phamtaiece/ECE411/Design goals/block diagram.jpg

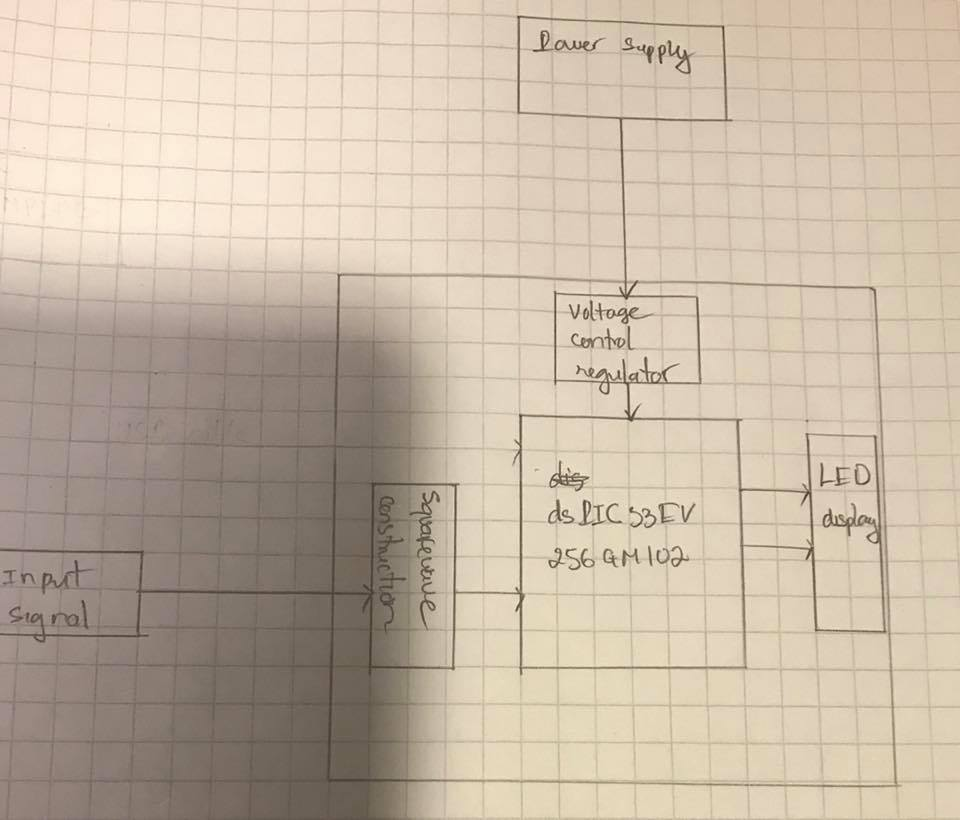
Design goals/block diagram.jpg
