phamtaiece/ECE411/Design schematic and relates/schematic.jpg

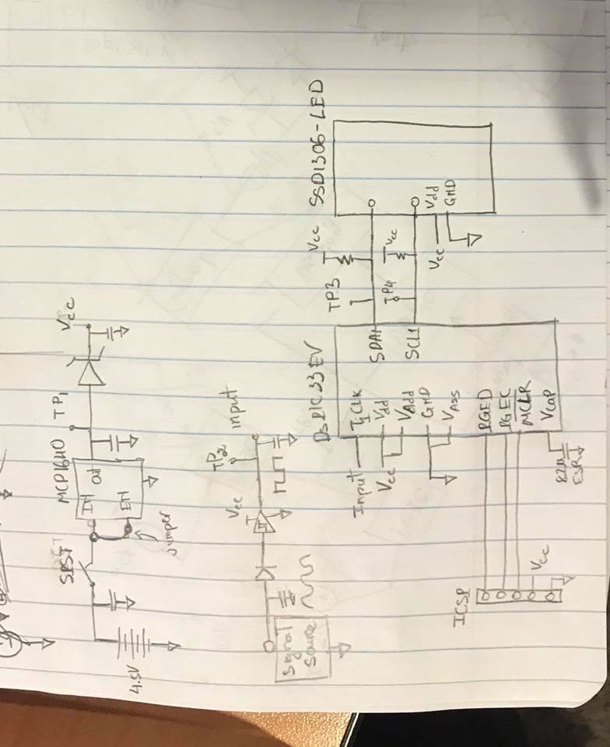
Design schematic and relates/schematic.jpg
