phamtaiece/ECE411/README.md

# ECE411
This is for ECE411 practicum. 
The project idea is where we post our idea. Come and contribute and have fun.
