phamtaiece/ECE411/Documents/Readme

I2c_fun help you how to turn on I2C communication. Using I2CCON1 or I2CCON2
Clicker_18F.... Help you about SSD1306 LED screen
FrequencyCounter source code... maybe helpful.
