phamtaiece/ECE411/Block Diagram.pdf

Level 0: Block Diagram

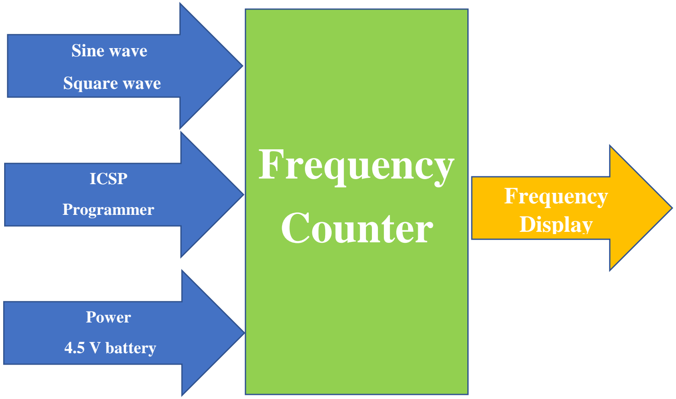
[picture p3: figure]
Sine wave; Square wave; ICSP; Programmer; Power; 4.5 V battery; Frequency; Counter; Frequency Display

Level 1: Block diagram

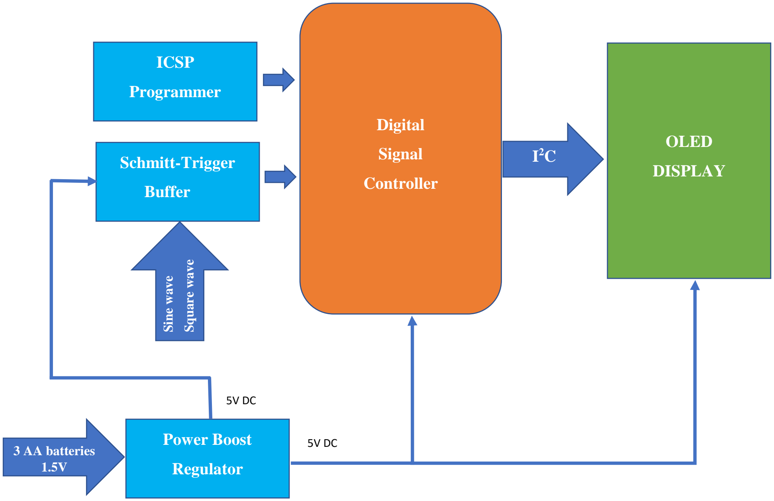
[picture p4: figure]
Power Boost; Regulator; 3 AA batteries 1.5V; Sine; wave; Square wave; Schmitt-Trigger; Buffer; ICSP; Programmer; Digital; Signal; Controller; OLED; DISPLAY
