phamtaiece/ECE411/BOM - Schematics - Layout/schematic.PNG

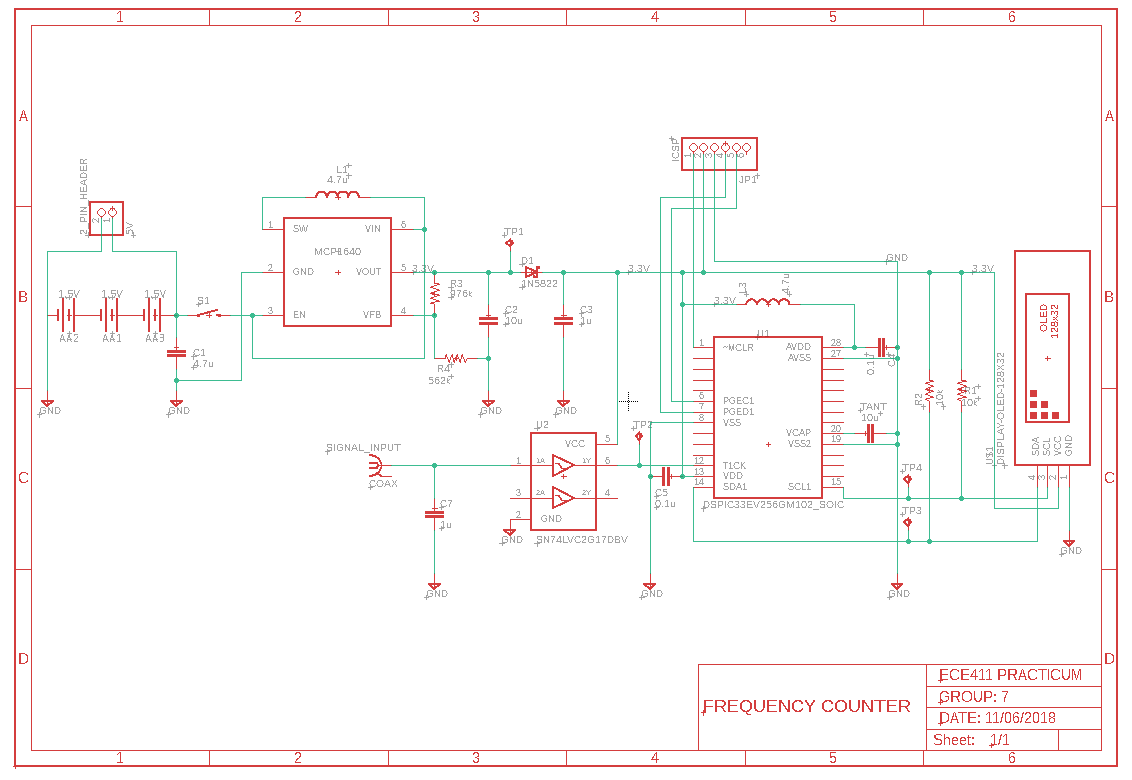
BOM - Schematics - Layout/schematic.PNG
