phamtaiece/ECE411/dsPIC33EV datasheet and relates/dsPIC Oscillator layout.jpg

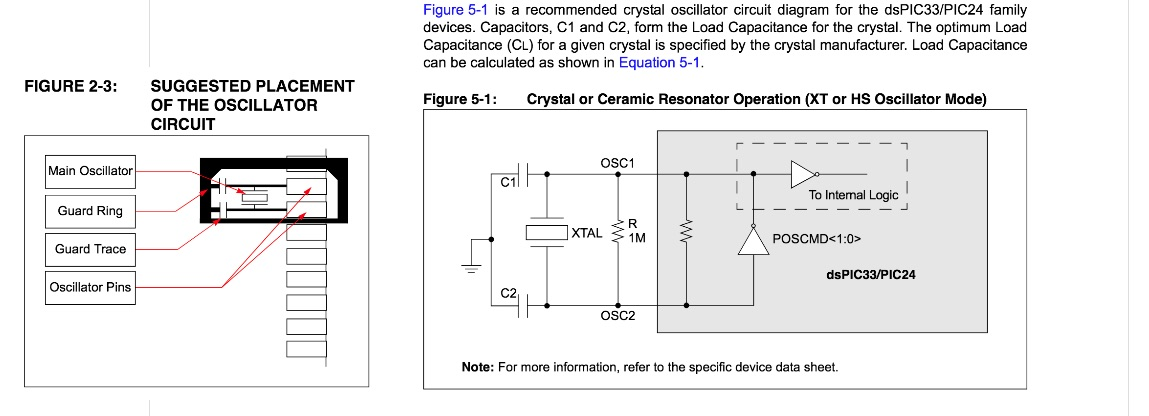
dsPIC33EV datasheet and relates/dsPIC Oscillator layout.jpg
