phamtaiece/ECE411/BOM - Schematics - Layout/Readme

BOM - Schematics - Layout for Frequency Counter
