phamtaiece/ECE411/BOM - Schematics - Layout/Practicum_BOM_11-9-18.ods

Device | Value | Package | Parts | Description | MFG | MPN | Vendor | Price | Qty | Subtotal
Resistor | 10k 1% | 0805 | R1 R2 | Resistor – Thick Film | Bourns | 652-CR0805FX-1002ELF | Mouser | $0.10 | 2 | $0.20
Resistor | 562K 1% | 0805 | R4 | Resistor – Thick Film | Bourns | 652-CR0805FX-5623ELF | Mouser | $0.10 | 1 | $0.10
Resistor | 976k 1% | 0805 | R3 | Resistor – Thick Film | Bourns | 652-CR0805FX-9763ELF | Mouser | $0.10 | 1 | $0.10
Capacitor | 0.1u 20% | 0805 | C4 C5 | Capacitor – Ceramic | KEMET | C0805C104M5RACTU | Mouser | $0.10 | 2 | $0.20
Capacitor | 10u 20% | Radial leaded | C2 | Capacitor – Aluminum Electrolytic | Panasonic | ECA-1HM100I | Mouser | $0.16 | 1 | $0.16
Capacitor | 10u 20% | Radial leaded | TANT | Capacitor – Aluminum Polymer | KEMET | A758BG106M1EAAE070 | Mouser | $0.47 | 1 | $0.47
Capacitor | 1u 20% | 0805 | C3 C7 | Capacitor – Ceramic | KEMET | C0805C104M5RACTU | Mouser | $0.13 | 2 | $0.26
Capacitor | 4.7u 20% | Radial leaded | C1 | Capacitor – Aluminum Electrolytic | KEMET | ESK475M100AC3AA (https://www.mouser.com/ProductDetail/KEMET/ESK475M100AC3AA) | Mouser | $0.10 | 1 | $0.10
Inductor | 4.7u 20% | 0805 | L1 L2 | Inductor – multi-layer | Bourns | 652-CV201210-4R7K | Mouser | 0.1 | 2 | $0.20
Battery Holder | 3x AA |  |  | 3x AA | Keystone | 2464 | Mouser | $1.43 | 1 | $1.43
BNC connector | Male | PC-mount |  | BNC Male Right-angle | Molex | 73137-5003 | Mouser | $1.97 | 1 | $1.97
Schmitt Buffer |  | SOT-26 |  | Dual Schmitt-trigger Buffer | Texas Instruments | SN74LVC2G17DBV | Mouser | $0.53 | 1 | $0.53
Switch | SPST | Solder Lug |  | Slide switch Right-angle | TE Connectivity | 1825232-1 | Mouser | $0.31 | 1 | $0.31
6-pin Header | 1 row 6 position | SIP-6 |  | Inline 6-position pin header | Harwin | M50-3530642 | Mouser | $0.24 | 1 | $0.24
PMIC |  | SOT-26 |  | MCP1640 | Microchip | MCP1640T-I/CHY | Mouser | $0.59 | 1 | $0.59
DSP |  | SOIC-28 |  | dsPIC33EV | Microchip | dsPIC33EV265GM102TI/SO | Mouser | $3.69 | 1 | $3.69
OLED backpack |  | SIP-4 |  | 128X32 OLED display with SSD1306 controller | MakerFocus | B079BN2J8V | Amazon | $5.50 | 1 | $5.50
 |  |  |  |  |  |  |  |  |  | $16.05
