phamtaiece/ECE411/411_SCH_FINAL.brd

## EAGLE design 411_SCH_FINAL.brd (2018-12-01)

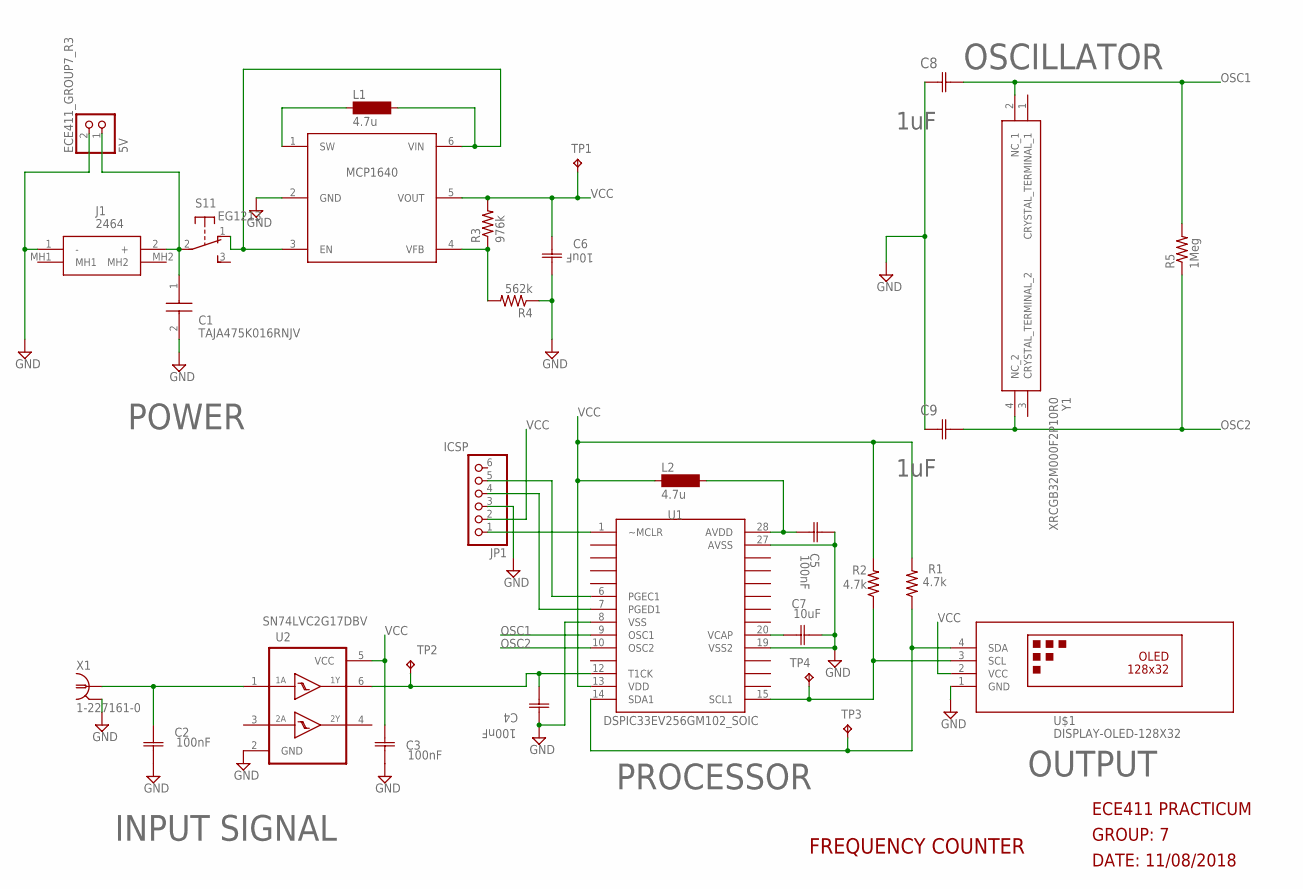
[picture p7: schematic 411_SCH_FINAL.sch]

Parts:
C1: TAJA475K016RNJV; CAPPM3216X180N
C2, C3, C4, C5: 100nF; CAPC2013X110N
C6, C7: 10uF; CAPC2013X140N
C8, C9: 1uF; CAPC2013X110N
ECE411_GROUP7_R3: 5V; JST-PH-2-THM-RA; MPN M20-9990246
J1: 2464
JP1: ICSP; 1X06
L1, L2: 4.7u; SM-1206
MCP1: MCP1640; SOP95P270X145-6; MPN MCP1640DT-I/CHY
R1, R2: 4.7k; M2012; MPN CR1206-JW-114ELF
R3: 976k; R0805
R4: 562k; R0805
R5: 1Meg; M0805
S1: EG1213
TP1, TP2, TP3, TP4: TPB1,27; B1,27
U1: DSPIC33EV256GM102_SOIC; SOIC127P1020X265-28; MPN DSPIC33EV256GM102
U2: SN74LVC2G17DBV; SOT23-6; MPN NC7WZ14P6X
U$1: DISPLAY-OLED-128X32; MPN SSD1306
X1: 1-227161-0; AMP_227161
Y1: XRCGB32M000F2P10R0; XRCGB32_F

Connections:
BATT: L1.2, MCP1.3 (EN), MCP1.6 (VIN), S1.1 (O)
GND: C1.2 (-), C2.2 (C2), C3.2 (C2), C4.2 (C2), C5.1 (C1), C6.2 (C2), C7.2 (C2), C8.1 (C1), C9.1 (C1), ECE411_GROUP7_R3.2 (1), J1.1 (-), JP1.3, MCP1.2 (GND), R4.1, U1.8 (VSS), U1.19 (VSS2), U1.27 (AVSS), U2.2 (GND), U$1.1 (GND), X1.2
unnamed: C7.1 (C1), U1.20 (VCAP)
unnamed: C1.1 (+), ECE411_GROUP7_R3.1 (2), J1.2 (+), S1.2
unnamed: R1.1, TP3.TP, U1.14 (SDA1), U$1.4 (SDA)
unnamed: C2.1 (C1), U2.1 (1A), X1.1
unnamed: C5.2 (C2), L2.2, U1.28 (AVDD)
unnamed: L1.1, MCP1.1 (SW)
unnamed: MCP1.4 (VFB), R3.1, R4.2
unnamed: JP1.1, U1.1 (~MCLR)
unnamed: R2.1, TP4.TP, U1.15 (SCL1), U$1.3 (SCL)
unnamed: JP1.4, U1.7 (PGED1)
unnamed: JP1.5, U1.6 (PGEC1)
unnamed: C4.1 (C1), TP2.TP, U1.12 (T1CK), U2.6 (1Y)
OSC1: C8.2 (C2), R5.2, U1.9 (OSC1), Y1.2 (NC_1)
OSC2: C9.2 (C2), R5.1, U1.10 (OSC2), Y1.4 (NC_2)
VCC: C3.1 (C1), C6.1 (C1), JP1.2, L2.1, MCP1.5 (VOUT), R1.2, R2.2, R3.2, TP1.TP, U1.13 (VDD), U2.5 (VCC), U$1.2 (VCC)

Notes on the sheet:
GROUP: 7
DATE: 11/08/2018
FREQUENCY COUNTER
ECE411 PRACTICUM
POWER
INPUT SIGNAL
OUTPUT
PROCESSOR
OSCILLATOR

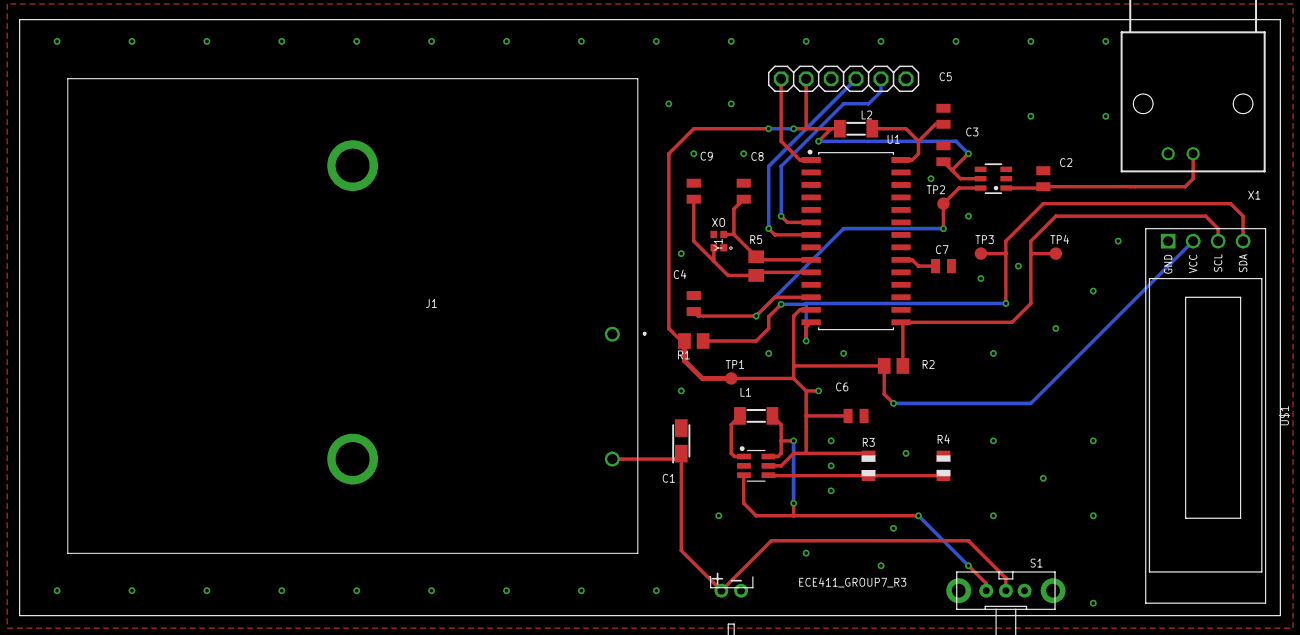
[picture p8: board 411_SCH_FINAL.brd from above]

Board: 2 copper layers, 128.2 x 60.6 mm, 30 parts (0 on the bottom side), 17 nets.
