phamtaiece/ECE411/freq_count_schematic_updated_11_6_2018.brd

## EAGLE design freq_count_schematic_updated_11_6_2018.brd (2018-11-08)

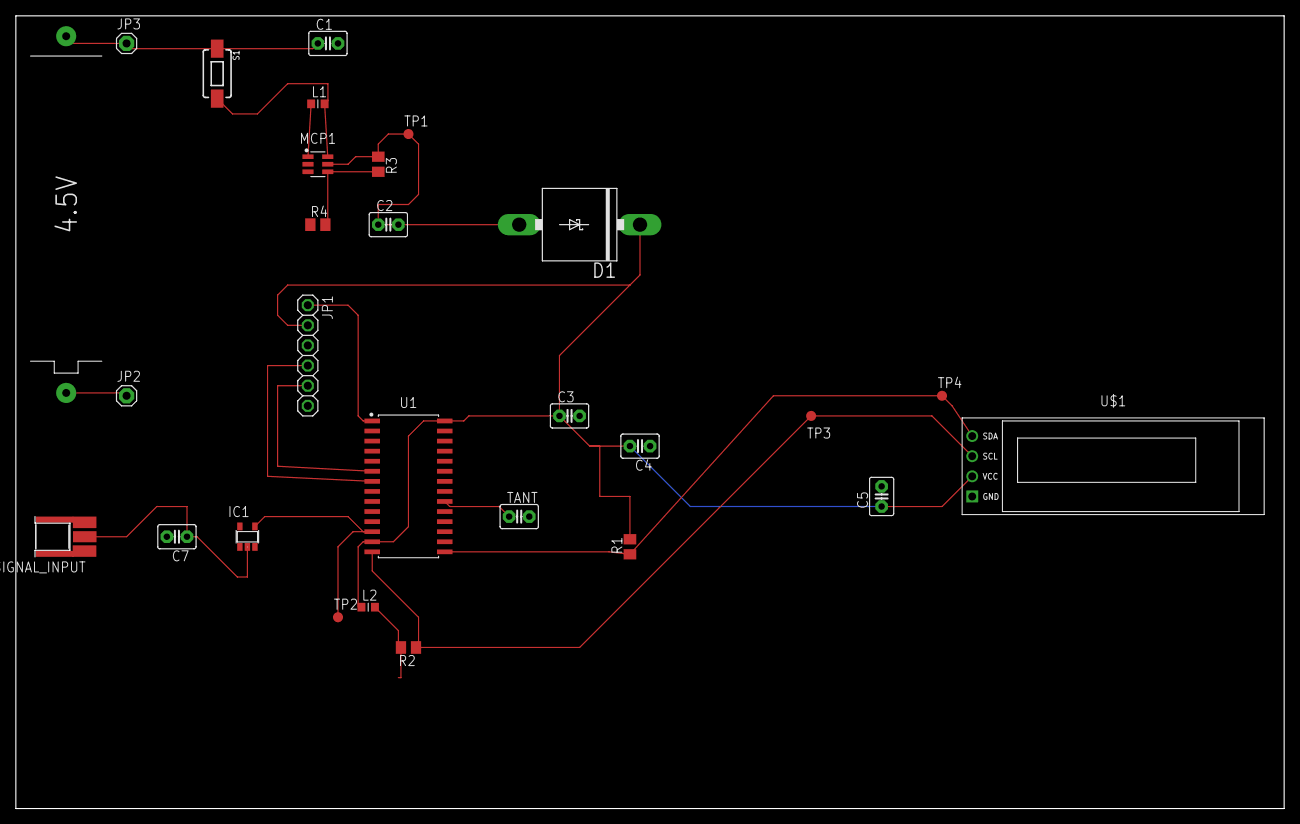
[picture p9: board freq_count_schematic_updated_11_6_2018.brd from above]

Board: 2 copper layers, 160.0 x 100.0 mm, 28 parts (0 on the bottom side), 15 nets.

Parts:
4.5V: AAA; 12BH412
C1: 4.7u; C2.5-3
C2: 10u; C2.5-3
C3, C7: 1u; C2.5-3
C4, C5: 0.1u; C2.5-3
D1: AG
IC1: 74AHC1G14DBV; SOT23-5
JP1: 1X06
JP2, JP3: 1X01
L1: 4.7u; L0603
L2: L0603
MCP1: MCP1640; SOP95P270X145-6
R1, R2: 10k; M2012
R3: 976k; M2012
R4: 562k; M2012
S1: RS032G05A3SM-SPST-MOMENTARY-SWSMD-1101NE; TACTILE-SWITCH-1101NE
SIGNAL_INPUT: COAX; MMCX-J-P-X-ST-EM1-MKT
TANT: 10u; C2.5-3
TP1, TP2, TP3, TP4: TPB1,27; B1,27
U1: DSPIC33EV256GM102_SOIC; SOIC127P1020X265-28
U$1: DISPLAY-OLED-128X32

Connections:
GND: 4.5V.+, C1.2, C2.2, C3.2, C4.1, C5.2, C7.2, IC1.3, JP1.3, JP2.1, MCP1.2, R4.1, SIGNAL_INPUT.2@1, SIGNAL_INPUT.2@2, SIGNAL_INPUT.2@3, SIGNAL_INPUT.2@4, TANT.2, U1.8, U1.19, U1.27, U$1.1
unnamed: TANT.1, U1.20
unnamed: 4.5V.-, C1.1, JP3.1, S1.1
unnamed: L1.2, MCP1.3, MCP1.6, S1.2
unnamed: C3.1, C4.2, C5.1, D1.C, JP1.2, L2.1, L2.2, R1.2, R2.2, U1.13, U1.28, U$1.2
unnamed: R1.1, TP4.TP, U1.15, U$1.4
unnamed: C7.1, IC1.2, SIGNAL_INPUT.1
unnamed: IC1.4, TP2.TP, U1.12
unnamed: C2.1, D1.A, MCP1.5, R3.1, TP1.TP
unnamed: R2.1, TP3.TP, U1.14, U$1.3
unnamed: L1.1, MCP1.1
unnamed: MCP1.4, R3.2, R4.2
unnamed: JP1.1, U1.1
unnamed: JP1.4, U1.7
unnamed: JP1.5, U1.6
