phamtaiece/ECE411/I2C_SSD1306/oled.h

/* 
 * File:   oled.h
 * Author: samwirshup
 *
 * Created on December 4, 2018, 2:47 PM
 */

/*
As this library is practically a a port of some of the functions available in
the Adafruit OLED library, all work here falls under their licencing aggreement:

Software License Agreement (BSD License)

Copyright (c) 2012 Adafruit Industries.  All rights reserved.

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
- Redistributions of source code must retain the above copyright notice,
  this list of conditions and the following disclaimer.
- Redistributions in binary form must reproduce the above copyright notice,
  this list of conditions and the following disclaimer in the documentation
  and/or other materials provided with the distribution.

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
 *
 *Addionally note: THESE FUNCTIONS ARE NOT TO BE USED AS IS. There is absolutly
 *NO checking on functions and many of them employ 'cheap hacks'. The point of
 *this code is to provide a starting point for you to make your own library
 *with, not to do the work for you :). Infact many things are intentionally
 *overlooked so that the lazy programmer will have a bad time. Dont include 3rd
 *party code in your projects that you havent even bothered to look throgh!
 *
 *The point of this library to so get the init the screen and show how to write
 *stuff to it.
 *
 */
#ifndef OLED_H
#define	OLED_H


#ifdef	__cplusplus
extern "C" {
#endif

    ////////////////////////////////////////////////////////////////////////////

#define OLED_SETCONTRAST 0x81
#define OLED_DISPLAYALLON_RESUME 0xA4
#define OLED_DISPLAYALLON 0xA5
#define OLED_NORMALDISPLAY 0xA6
#define OLED_INVERTDISPLAY 0xA7
#define OLED_DISPLAYOFF 0xAE
#define OLED_DISPLAYON 0xAF
#define OLED_SETDISPLAYOFFSET 0xD3
#define OLED_SETCOMPINS 0xDA
#define OLED_SETVCOMDETECT 0xDB
#define OLED_SETDISPLAYCLOCKDIV 0xD5
#define OLED_SETPRECHARGE 0xD9
#define OLED_SETMULTIPLEX 0xA8
#define OLED_SETLOWCOLUMN 0x00
#define OLED_SETHIGHCOLUMN 0x10
#define OLED_SETSTARTLINE 0x40
#define OLED_MEMORYMODE 0x20
#define OLED_COLUMNADDR 0x21
#define OLED_PAGEADDR   0x22
#define OLED_COMSCANINC 0xC0
#define OLED_COMSCANDEC 0xC8
#define OLED_SEGREMAP 0xA0
#define OLED_CHARGEPUMP 0x8D

///////////////////////////////////////////////////////////////////////////////

//These were stolen from a random site i forgot the name of. Note,
//the characters are 8 pixels tall so as to take advantage of vertical
//addressing. Keep that in mind if you move to horozontal addressing.
static const unsigned char OLED_characters[] = {
        0x00, 0x00, 0x00, 0x00, 0x00,	 // 	(Space)
  	0x00, 0x00, 0x5F, 0x00, 0x00,	 // 	!
  	0x00, 0x07, 0x00, 0x07, 0x00,	 // 	"
  	0x14, 0x7F, 0x14, 0x7F, 0x14,	 // 	#
  	0x24, 0x2A, 0x7F, 0x2A, 0x12,	 // 	$
  	0x23, 0x13, 0x08, 0x64, 0x62,	 // 	%
  	0x36, 0x49, 0x56, 0x20, 0x50,	 // 	&
  	0x00, 0x08, 0x07, 0x03, 0x00,	 // 	'
  	0x00, 0x1C, 0x22, 0x41, 0x00,	 // 	(
  	0x00, 0x41, 0x22, 0x1C, 0x00,	 // 	)
  	0x2A, 0x1C, 0x7F, 0x1C, 0x2A,	 // 	*
  	0x08, 0x08, 0x3E, 0x08, 0x08,	 // 	+
  	0x00, 0x00, 0x70, 0x30, 0x00,	 // 	,
  	0x08, 0x08, 0x08, 0x08, 0x08,	 // 	-
  	0x00, 0x00, 0x60, 0x60, 0x00,	 // 	.
  	0x20, 0x10, 0x08, 0x04, 0x02,	 // 	/
  	0x3E, 0x51, 0x49, 0x45, 0x3E,	 // 	0
  	0x00, 0x42, 0x7F, 0x40, 0x00,	 // 	1
  	0x72, 0x49, 0x49, 0x49, 0x46,	 // 	2
  	0x21, 0x41, 0x49, 0x4D, 0x33,	 // 	3
  	0x18, 0x14, 0x12, 0x7F, 0x10,	 // 	4
  	0x27, 0x45, 0x45, 0x45, 0x39,	 // 	5
  	0x3C, 0x4A, 0x49, 0x49, 0x31,	 // 	6
  	0x41, 0x21, 0x11, 0x09, 0x07,	 // 	7
  	0x36, 0x49, 0x49, 0x49, 0x36,	 // 	8
  	0x46, 0x49, 0x49, 0x29, 0x1E,	 // 	9
  	0x00, 0x00, 0x14, 0x00, 0x00,	 // 	:
  	0x00, 0x40, 0x34, 0x00, 0x00,	 // 	;
  	0x00, 0x08, 0x14, 0x22, 0x41,	 // 	<
  	0x14, 0x14, 0x14, 0x14, 0x14,	 // 	=
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
0x00, 0x00, 0x00, 0x00, 0x00, 0x00, 0x00, 0x00, 0x00, 0x00, 0x00, 0x00, 0x00, 0x00, 0x00, 0x00,
0x00, 0x00, 0x00, 0x00, 0x00, 0x00, 0x00, 0x00, 0x00, 0x00, 0x00, 0x00, 0x00, 0x00, 0x00, 0x00,
0x00, 0x00, 0x00, 0x00, 0x00, 0x00, 0x00, 0x00, 0x00, 0x00, 0x00, 0x00, 0x00, 0x00, 0x00, 0x00,
0x00, 0x00, 0x00, 0x00, 0x00, 0x00, 0x00, 0x00, 0x00, 0x00, 0x00, 0x00, 0x00, 0x00, 0x00, 0x00,
0x00, 0x00, 0x00, 0x00, 0x00, 0x00, 0x00, 0x00, 0x00, 0x00, 0x00, 0x00, 0x00, 0x00, 0x00, 0x00
};

char _address = 0x78;
    
void OLED_Init(char address);
void OLED_command(char command);
void OLED_data(char data);
void OLED_write();
void OLED_clear();
void OLED_invert();
void OLED_rscroll(char start, char stop);
void OLED_lscroll(char start, char stop);
void OLED_stopscroll();
void OLED_pixel(short x, short y, char color);
void OLED_char(char character, short x, short y);
void OLED_string(char* str, short x, short y);
#ifdef	__cplusplus
}
#endif

#endif	






#ifdef	__cplusplus
}
#endif

#endif	/* OLED_H */
