phamtaiece/ECE411/(commit log)

2018-10-17 Understanding I2C
    Excellent document for review about how I2C works
2018-10-18 Add files via upload
    LED driver chip built into LED display
2018-10-29 Portable Frequency Counter Schematic (EAGLE)
    Schematic of our design as of 10-28-2018 in Eagle
    [freq_counter_WB_group7.sch]
2018-11-02 I2C practice
    Our first attempt at using the I2C module
2018-11-08 initial board layout
    [freq_count_schematic_updated_11_6_2018.brd]
2018-11-10 Updated BOM with parts available from Mouser
    [Practicum_BOM_11-9-18.ods]
2018-12-01 MOST RECENT SCHEMATIC
    as of 12/1/2018
    [411_SCH_FINAL.brd, 411_SCH_FINAL.sch]
2018-12-05 Add files via upload
    Code for OLED SSD1306 and I2C
